Adam0Brien/USV-LIR-Microbit-Abstraction/README.md

# USV-LIR-Microbit-Abstraction
Final year project Applied Computing (IoT)

## Academic Title - "USV-Lir Micro: bit Sensor Pod Abstraction"

## Commercial Title - "Micro:Bit Sensor Pod breakout Board"
<br>
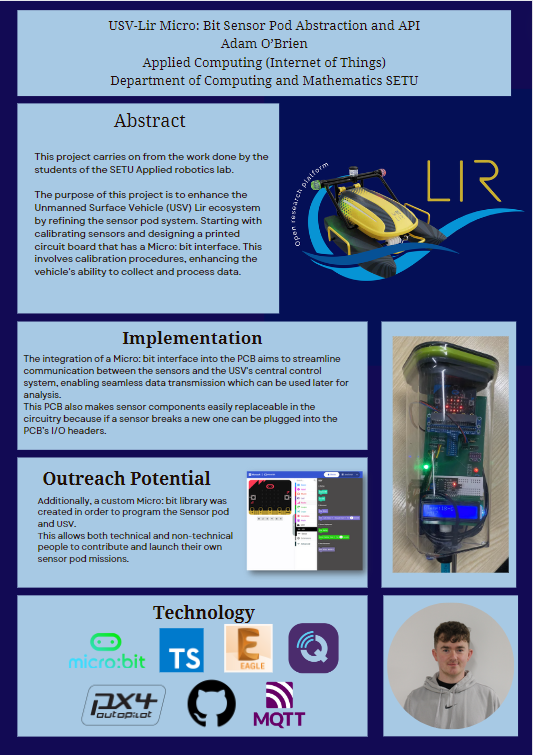
[picture p1: img/poster.png]

<br>
