Adam0Brien/USV-LIR-Microbit-Abstraction/docs/hardware.md

# Sensor Pod Hardware
This section will guide you through the hardware components of the project.

## Component Requirements

- Sensor Pod PCB 
- [Microbit Breadboard adapter](https://shop.sb-components.co.uk/products/bbc-micro-bit-breadboard-adapter)
- [I2C LCD Screen adapter](https://makershop.ie/I2C-Display-Backpack)
- [LCD Screen](https://makershop.ie/2004-lcd-display)
- [DS18B20 Arduino Temperature sensor](https://docs.rs-online.com/8ff0/A700000007238410.pdf)

- [DFRobot pH sensor](https://wiki.dfrobot.com/PH_meter_SKU__SEN0161_)
- [DFRobot Turbidity sensor](https://www.dfrobot.com/product-1394.html)
- LDR
- [Breadboard 3.3/5v power adapter](https://www.temu.com/ul/kuiper/un9.html?goods_id=601099524060004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)
- 4.7k Resistor (for temperature sensor)
- 10k Resistor (for LDR)
- 330 ohm Resistor x2 (Power LEDS)
- Pin sockets
- Enclosure

# Pin outs

On the sensor pod each sensor has its own dedicated pin slot, 
This means that components will only go one way into the device.

The I2C connections can be swapped aslong as the right voltage is being supplied to the I2C device. e.g. The LCD display must have 5v power to work correctly.

Below you will find the current PCB iteration along with letters over specific pins to indicate what those pins do.

- V = VCC (Power 3.3v or 5v)
- G = Ground
- S = Signal
- X = SDA (I2C)
- Y = SCL (I2C)

Sensor/I2C Micro: bit pin signals
- Temp -> Digital Pin 8
- pH -> Analog Pin 0
- Turbidity -> Analog Pin 1
- LDR -> Analog Pin 2
- M1 -> Analog Pin 3
- M2 -> Analog Pin 4
- SCL -> Pin 19
- SDA -> Pin 20

<div style="text-align: center;">
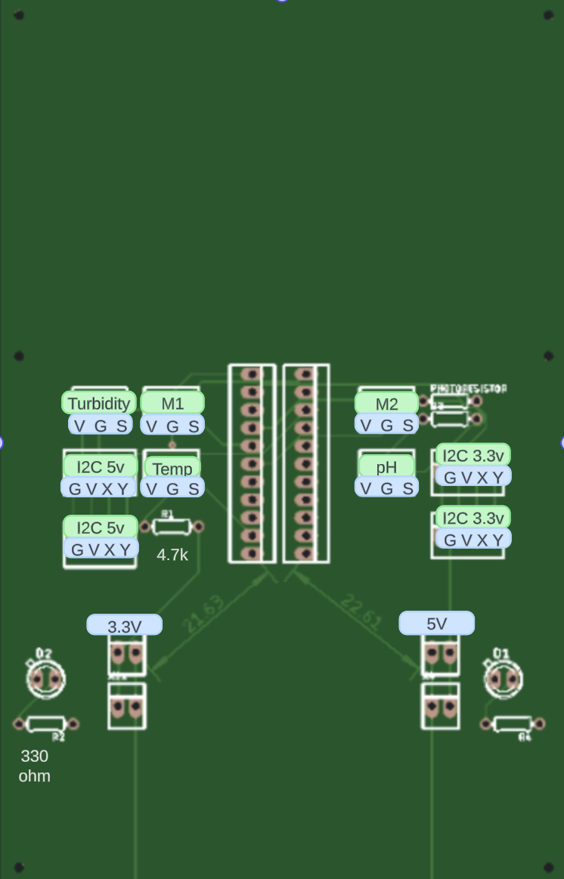
[picture p5: img/pcb-pinout.png]
        
</div>
