Adam0Brien/USV-LIR-Microbit-Abstraction/pcb-design/pdb.md

# USV-LIR-Microbit-Abstraction PCB Design

The following design contains connections for the microbit breadboard expantion board, power mb v2 board, 3x I2C pinouts, 2x Motor control pinouts and 3x sensor pinouts.

This makes the board usable for the sensor deployment system along with the microbit remote drive system.

<br>

<br>

<br>

<br>
