Adam0Brien/USV-LIR-Microbit-Abstraction/docs/pcb.md

# USV-LIR-Microbit-Abstraction PCB Design

The following design contains connections for the microbit breadboard expantion board, power mb v2 board, 3x I2C pinouts, 2x Motor control pinouts and 3x sensor pinouts.

This makes the board usable for the sensor deployment system along with the microbit remote drive system.

<br>
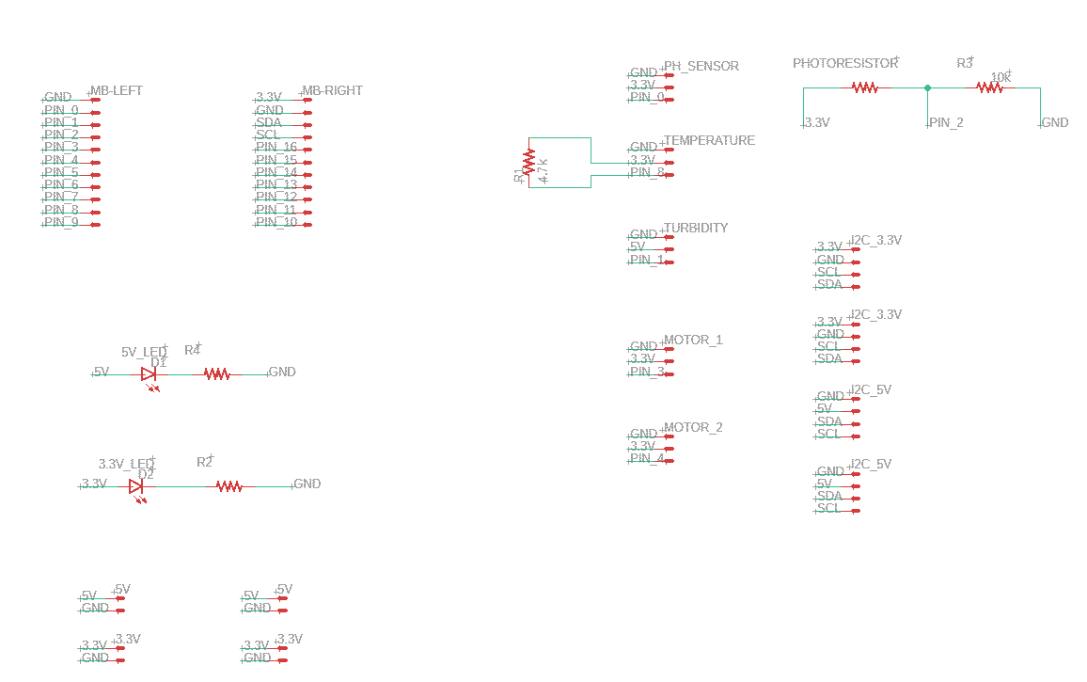
[picture p6: img/pcb-schematic.png]

<br>

<br>
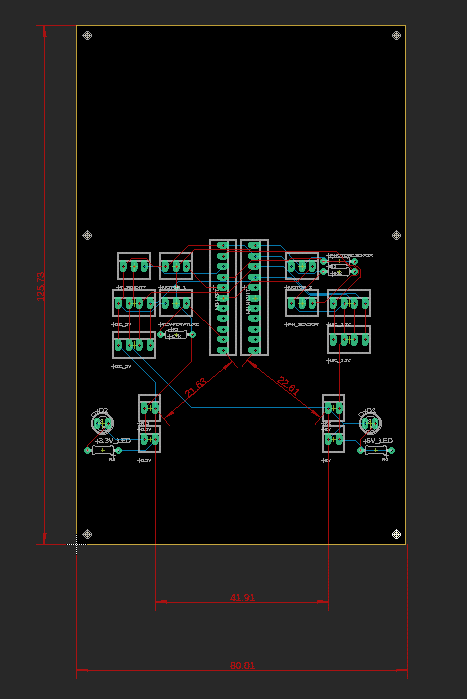
[picture p7: img/pcb.png]

<br>

<br>
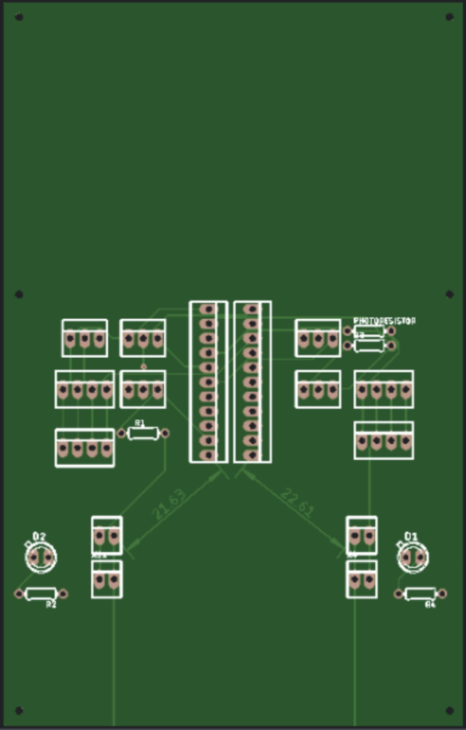
[picture p8: img/pcb-render.png]

<br>
