Adam0Brien/USV-LIR-Microbit-Abstraction/img/3DPrint.png

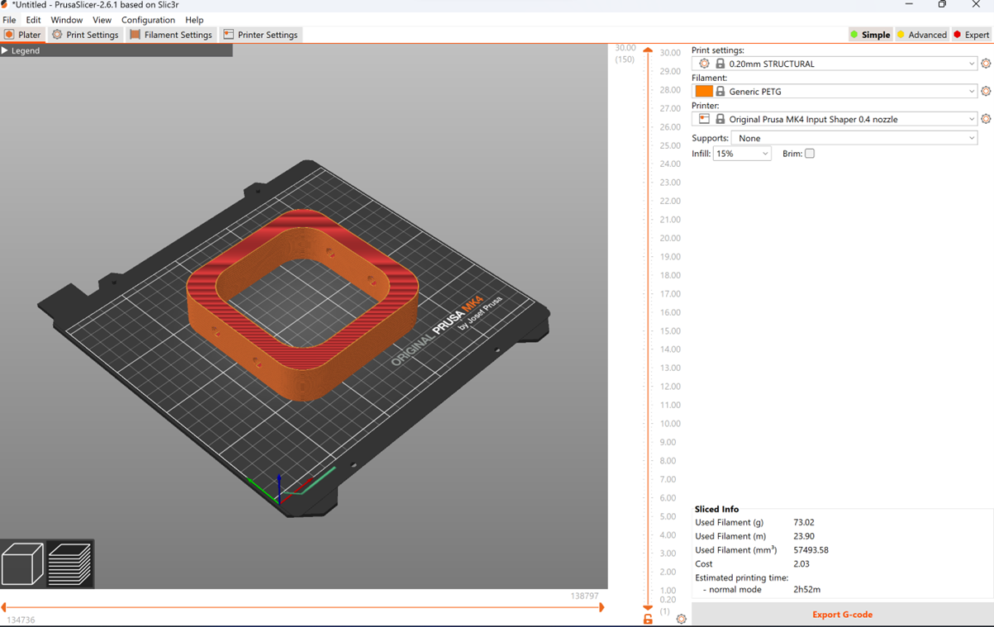
img/3DPrint.png
