Adam0Brien/USV-LIR-Microbit-Abstraction/img/USVLIR.jpg

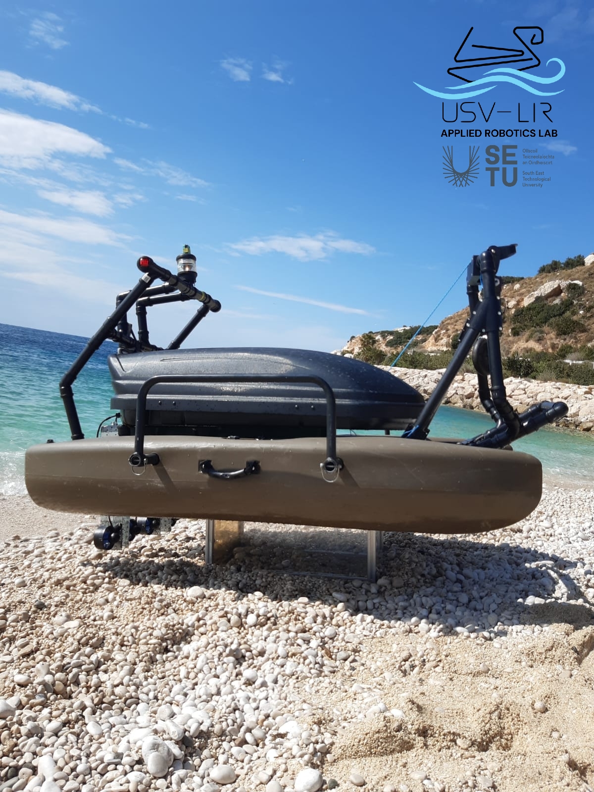
img/USVLIR.jpg
