Adam0Brien/USV-LIR-Microbit-Abstraction/3D Print Files/STL/Sensor-Pod-Inside.stl

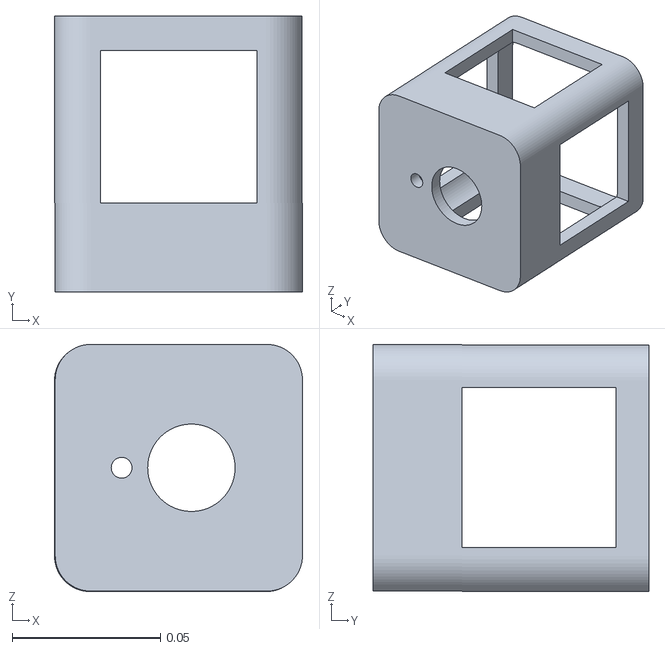
[picture p11: CAD file, 2024-04-24]
3D Print Files/STL/Sensor-Pod-Inside.stl
0.0836 x 0.0929 x 0.0833
