Adam0Brien/USV-LIR-Microbit-Abstraction/3D Print Files/STL/Sensor-Pod-Clamp.stl

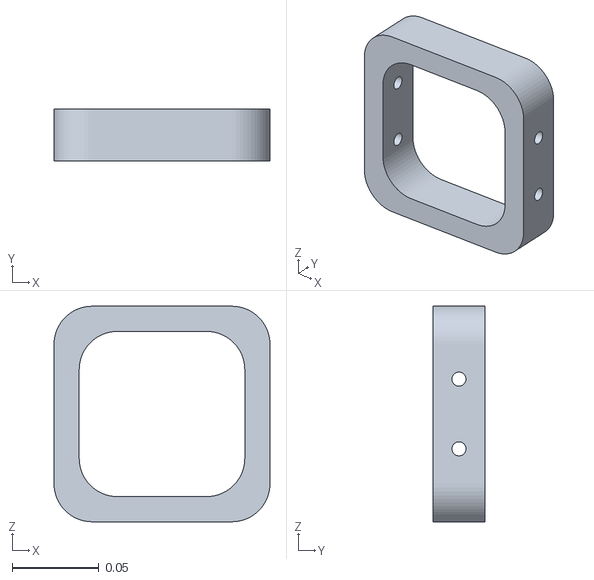
[picture p12: CAD file, 2024-04-24]
3D Print Files/STL/Sensor-Pod-Clamp.stl
0.125 x 0.03 x 0.124
