Adam0Brien/USV-LIR-Microbit-Abstraction/pcb-design/sensor-pod.brd

## EAGLE design pcb-design/sensor-pod.brd (2024-02-19)

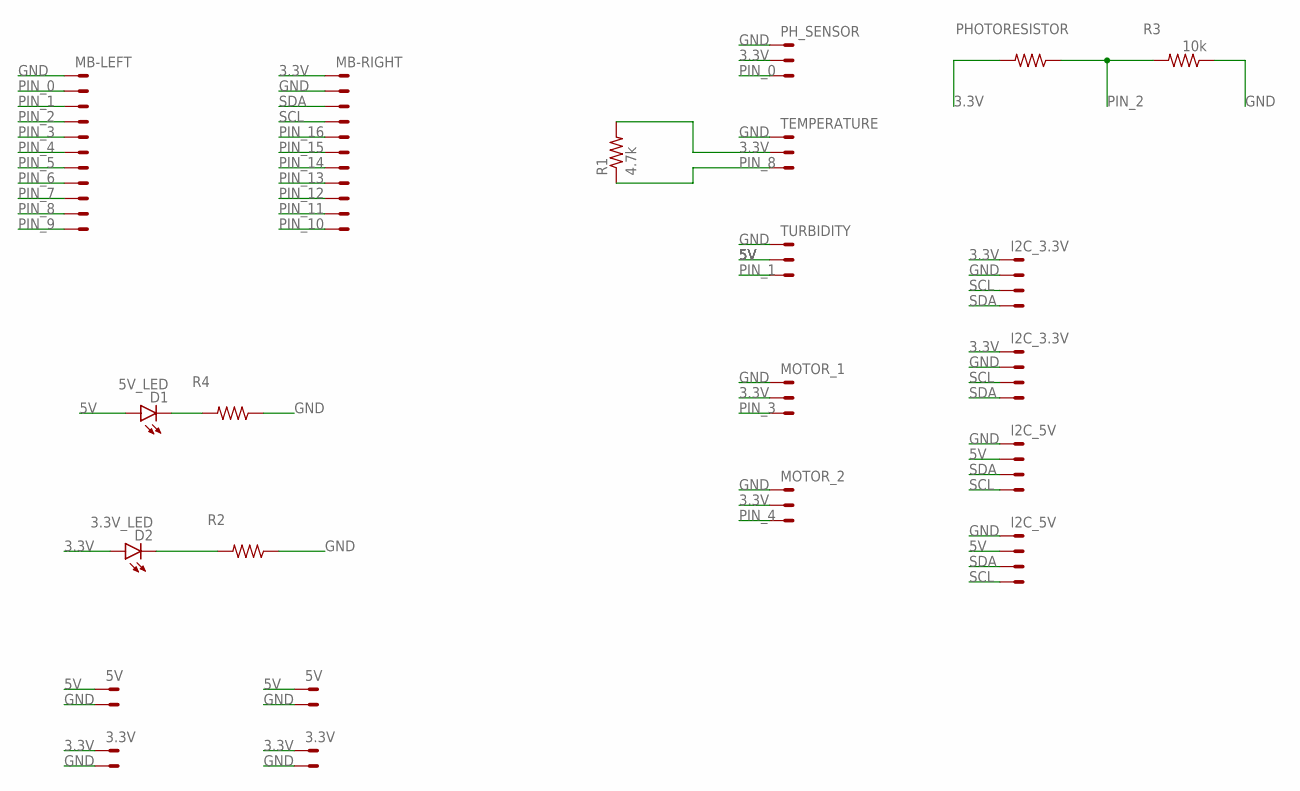
[picture p13: schematic sensor-pod.sch]

Parts:
1: 5V; 22-23-2021
D1: 5V_LED; SFH482
D2: 3.3V_LED; SFH482
PHOTORESISTOR: R-US_0204/7; 0204/7
R1: 4.7k; 0204/7
R2, R4: R-US_0204/7; 0204/7
R3: 10k; 0204/7
X1: PH_SENSOR; 22-23-2031
X2, X10: I2C_5V; 22-23-2041
X3: TURBIDITY; 22-23-2031
X4: 5V; 22-23-2021
X5: TEMPERATURE; 22-23-2031
X6: MOTOR_1; 22-23-2031
X7: MOTOR_2; 22-23-2031
X8, X9: I2C_3.3V; 22-23-2041
X11, X12: 3.3V; 22-23-2021
X15: MB-LEFT; 22-23-2111
X16: MB-RIGHT; 22-23-2111

Connections:
3.3V: D2.A, PHOTORESISTOR.2, R1.2, X1.2, X5.2, X6.2, X7.2, X8.1, X9.1, X11.1, X12.1, X16.1
5V: 1.1, D1.A, X2.2, X3.2, X4.1, X10.2
GND: 1.2, R2.1, R3.1, R4.1, X1.1, X2.1, X3.1, X4.2, X5.1, X6.1, X7.1, X8.2, X9.2, X10.1, X11.2, X12.2, X15.1, X16.2
unnamed: D1.K (C), R4.2
unnamed: D2.K (C), R2.2
PIN_0: X1.3, X15.2
PIN_1: X3.3, X15.3
PIN_2: PHOTORESISTOR.1, R3.2, X15.4
PIN_3: X6.3, X15.5
PIN_4: X7.3, X15.6
PIN_5: X15.7
PIN_6: X15.8
PIN_7: X15.9
PIN_8: R1.1, X5.3, X15.10
PIN_9: X15.11
PIN_10: X16.11
PIN_11: X16.10
PIN_12: X16.9
PIN_13: X16.8
PIN_14: X16.7
PIN_15: X16.6
PIN_16: X16.5
SCL: X2.4, X8.3, X9.3, X10.4, X16.4
SDA: X2.3, X8.4, X9.4, X10.3, X16.3

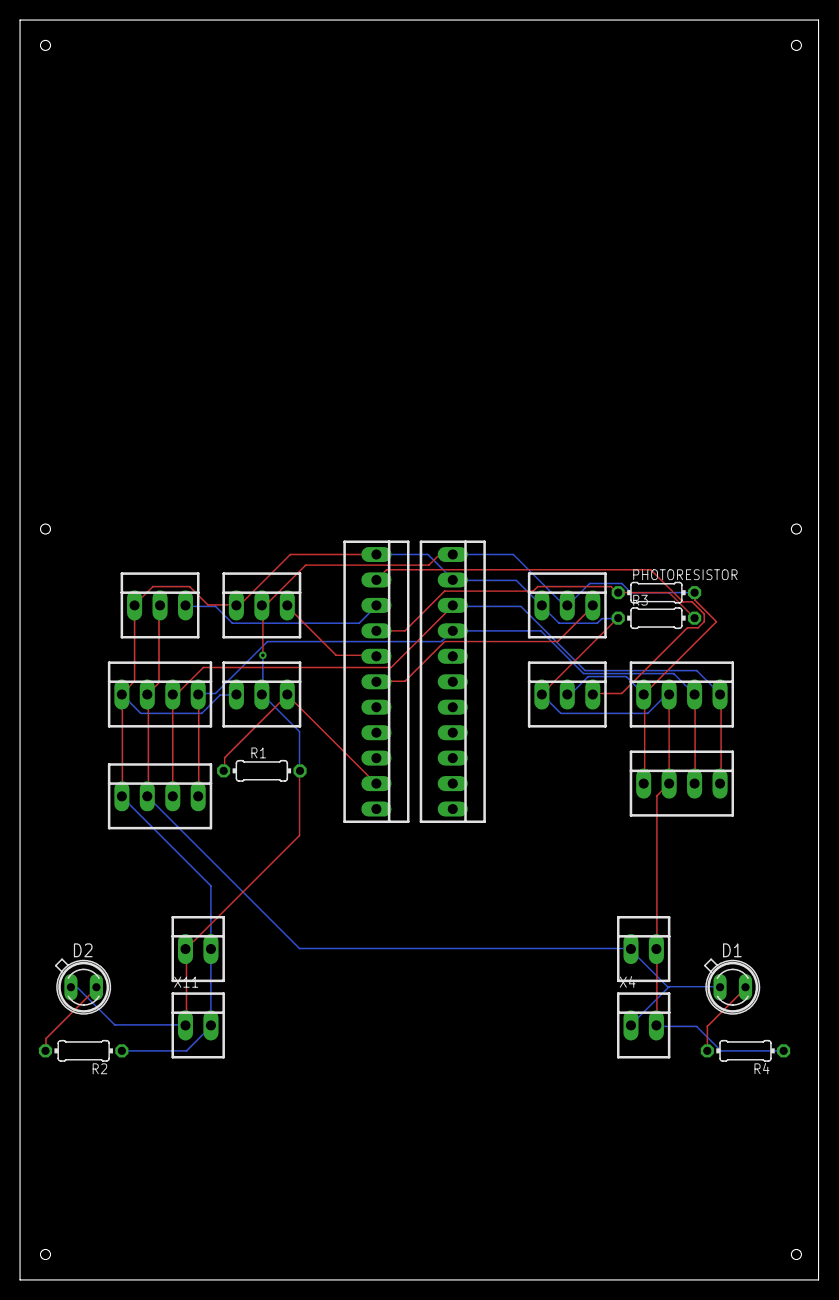
[picture p14: board sensor-pod.brd from above]

Board: 2 copper layers, 79.7 x 125.7 mm, 22 parts (0 on the bottom side), 13 nets.
