Adam0Brien/USV-LIR-Microbit-Abstraction/docs/getting-started.md

# Getting Started with USV-Lir Sensor Pod
Welcome to USV-Lir Sensor Pod! This document will guide you through the process of setting up and getting started with the project.

Prerequisites

Before you begin, make sure you are familiar with the following:

- BBC Microbit (or Scratch)
- Electronics (Not neccessary but an advantage)

## Usage
To get started with the USV-Lir Sensor Pod, follow these steps:

- Make sure that all sensors are attatched to the main PCB board.

- Install the Sensor Pod library to makecode
    - Open a new makecode project 
    - Switch to Javascript and open the dropdown menu labeled 'Explorer'
    
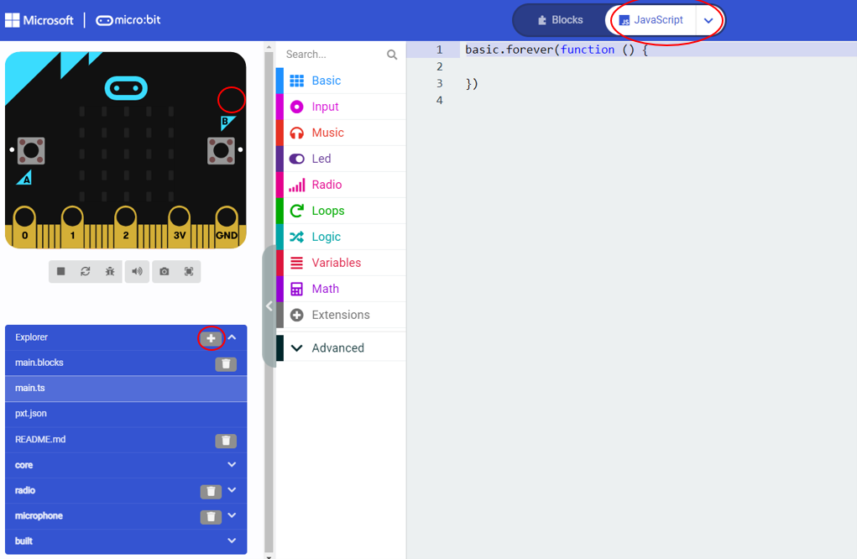
[picture p15: img/getting-started1.png]
    
    
    - Click on the '+' icon and make a new file called 'sensorPod.ts'
        
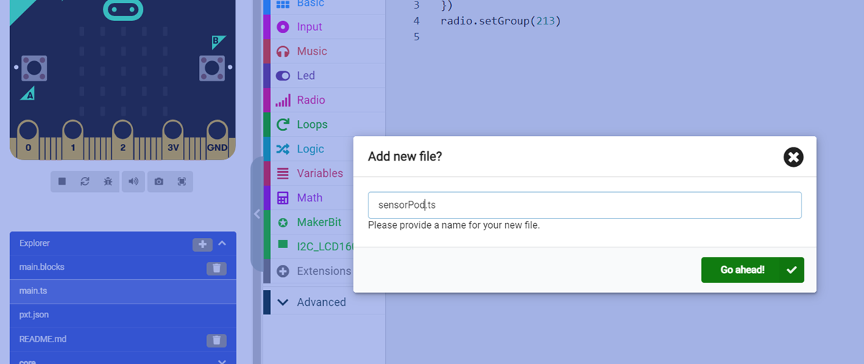
[picture p16: img/getting-started2.png]
    
    
    - Paste the code from https://github.com/Adam0Brien/USV-LIR-Microbit-Abstraction/blob/main/USV/sensor-pod/sensorPod.ts
    
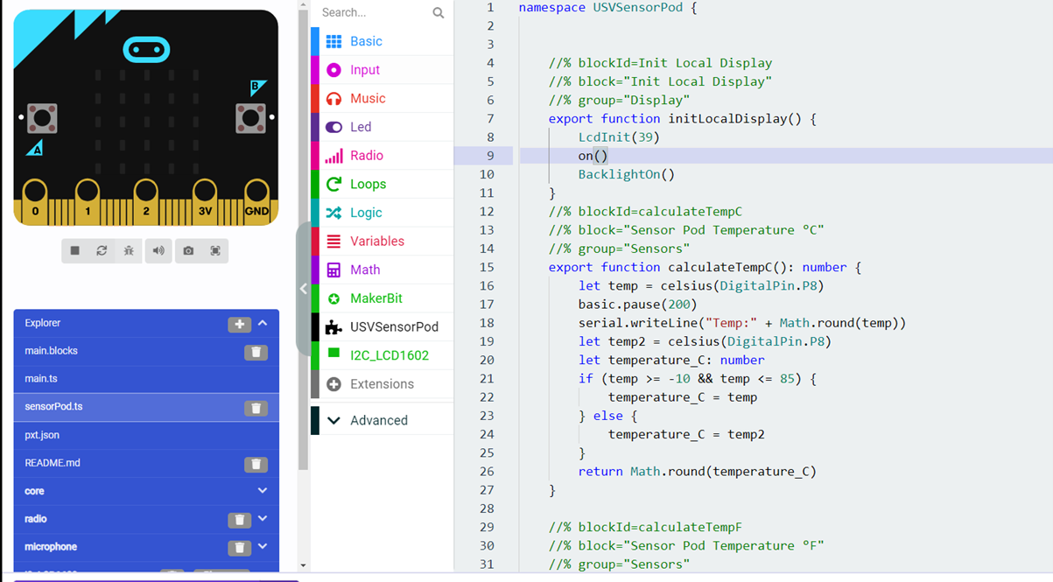
[picture p17: img/getting-started3.png]
    
    
    - Switch back from Javascript to Blocks
    
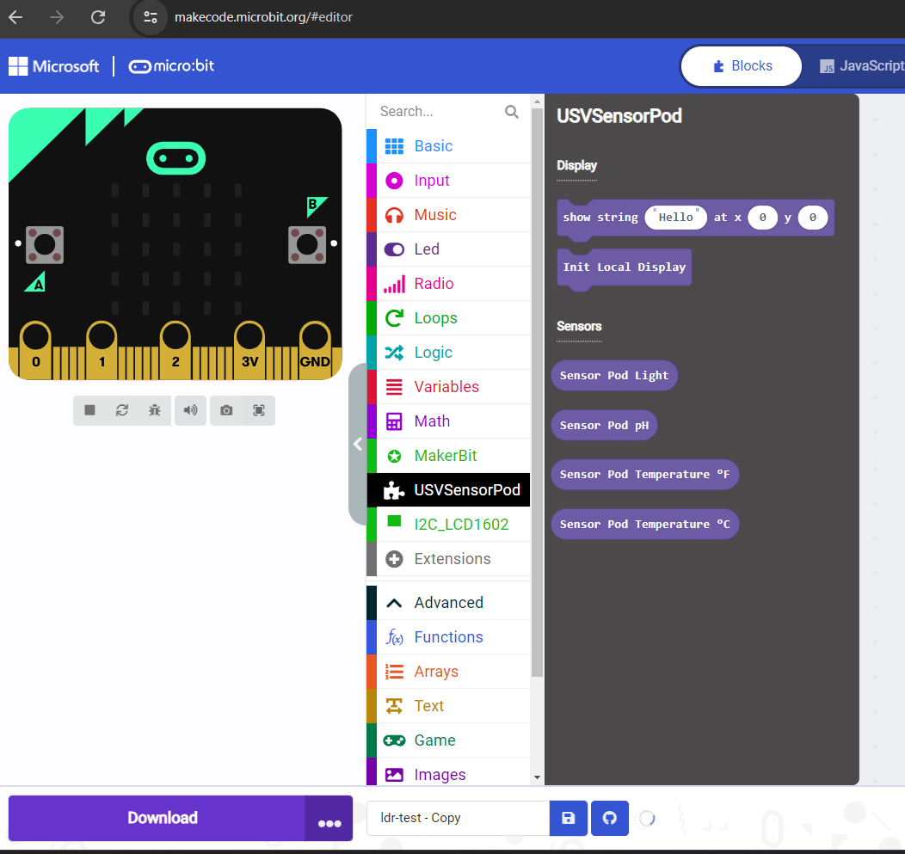
[picture p18: img/getting-started4.png]
    
    
    - Code your first sensor pod mission!!!
    
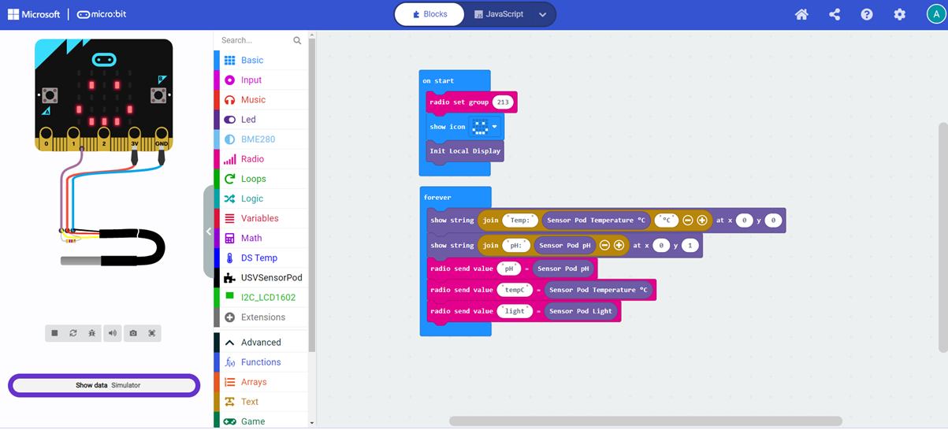
[picture p19: img/getting-started5.png]
    

## Contributing
If you're interested in contributing to USV-Lir Sensor Pod, please follow these guidelines:
 
#### Fork the repository.
- Clone respository
- Create a new branch: git checkout -b feature/your-feature.
- Make your changes and commit them: git commit -m 'feat: Add some feature'.
- Push to the branch: git push origin feature/your-feature.
- Submit a pull request.

# Contact
If you have any questions or need further assistance, feel free to contact me at adamobrieniot@gmail.com.
