Adam0Brien/USV-LIR-Microbit-Abstraction/(threads)

Thread 15 (2024-03-11):

Implement USV Sensor Deployment mechanism into Microbit library

Adam0Brien, 2024-03-11:
Using the breakout pins on the microbit expantion board make a microbit makeblock that lets a user gain access to the USV's sensor deployment mechanism.

This paired with #14 will allow users to drive the USV to a location and deploy the sensor pod.

e.g.

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

Note:
Currently the Sensor deployment mechanism is wired directly into the Pixhawk meaning that there is no current microbit implementation of this feature

This is a major change compared to #14 because for this change the wiring will have to be altered so it is directly connected to the MUX.

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

Adam0Brien, 2024-03-14:
After todays lab testing the following has been completed:
- Crane up/down connection has been rewired from the Pixhawk to the MUX
- MUX output is only connected to the microbit for now.
- Added a Stop option to the Crane dropdown
- Wrote makecode for making the crane move up/down on a button press
- Added safety code on the controller so when the A or B button is released the Crane will stop moving

Reciever Code:
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

Controller Code:
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

Adam0Brien, 2024-03-15:
Lab Work competed today,

- Wired Pixhawk into MUX
- Tested microbit and Pixhawk sensor deployment modes and both work
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

Adam0Brien, 2024-03-15:
Finished Product

- Features a seconds variable that will send the sensor pod up/down for x amount of seconds
- Separate Stop makeblock

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

Closed 2024-03-15.

Thread 16 (2024-03-11):

Create USV to Sensor pod comms

Adam0Brien, 2024-03-11:
Currently the Sensor pod library is used to code the sensor pod itself.

The proposed change will take place in the USV library.

The sensor drop down will be used for the USV to communicate with the sensor pod Via radio comms.
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
The only values that will be available are the sensors themselves.
e.g.
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

The end goal of this PR is to be able to have the sensor pod pre-loaded with its own script that takes measurements when it is submerged and to have the USV ask for sensor pod metrics once it re-emerges from the water

Adam0Brien, 2024-04-04:
Opted to make a generic block that the user can select what value they want to look at

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

Thread 17 (2024-03-14):

Create Mounting Bracket for Sensor pod

Adam0Brien, 2024-03-14:
Currently the sensor pod has no means of attaching to the Crane mechanism...

Design and manufacture a simple means of attaching the sensor pod the crane mechanism.

Adam0Brien, 2024-03-14:
3D design for half of a bracket.

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

Printing two brackets will allow the brackets to act as a clamp by connecting them with threaded bar to keep the sensor pod attatched to the USV's Crane

Adam0Brien, 2024-03-15:
On second thought two separate pieces would make it harder to disassemble the sensor pod, instead of this a full bracket will be printed.

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

Adam0Brien, 2024-03-16:
Finished Product:

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

Closed 2024-03-15.

Thread 20 (2024-03-15):

Implement USV Sensor Pod to Beebotte Cloud

Adam0Brien, 2024-03-15:
Previously the USV had been able to be controlled and viewed from the IoT MQTT Panel Application.

Using the DFRobot Microbit IoT Cloud board the following has to be completed.

  - Sensor deployment control via App
  - Motor control via App (Needs #14)
  - Sensor Pod data being sent to Beebotte/IoT App (Needs #16)

This feature will enable the Sensor Pod to send data back to the cloud board for viewing sensor pod metrics

Closed 2024-04-06.

Thread 22 (2024-03-19):

Implement Motor control via micro:bit Compass position.

Adam0Brien, 2024-03-19:
**This feature would bring the addition of two new make blocks for the library.**
Using the motor control functions merged in #14

- Get USV direction (return a compass value)
- Drive USV North at X%  (sends radio messages based on compass value)
     - An example would be: if the USV is facing south turn until it is facing north, then once it is north drive the USV motors for X time
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

**Additional context**
This should work by having one micro:bit being used as a dedicated compass for the system that sends its position to the motor control micro:bit.
Once the compass has been positioned at north it should start to move the USV's motors at the desired speed selected for X amount of time

Adam0Brien, 2024-03-22:
Concept of what the new makeblock could look like:

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

Adam0Brien, 2024-03-22:
Progress made during todays lab time:

- Created a microbit script that moves USV motors using Microbit A. Controlled by the direction Microbit B's compass is pointing
- This script will power the USV's Thrusters and adjust for any deviation the USV might see on the water and keep it moving in the direction selected
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

Adam0Brien, 2024-03-26:
### Work done in lab today:

- Fixed Correct Course Logic
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

- Made demo video of code working with USV Thrusters.

## TODO

Give the drive north command a timer variable.
Make sure it is within the correct degree direction before timer starts to count down

Current version:
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

Intended version:
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

Closed 2024-04-04.
