Adam0Brien/USV-LIR-Microbit-Abstraction/(commit log)

2024-01-17 pcb-design: Added initial PCB design for sensor pod
    [sensor-pod.brd, sensor-pod.sch]
2024-01-17 pcb-design: Added pcb.md along with screenshots of design
2024-01-18 pcb-design/pcb.md: Correct image file extention
2024-01-18 pcb-design: Changed board layout and assigned pins for sensors.
    [sensor-pod.brd, sensor-pod.sch]
2024-01-23 Added Temperature sensor code.
2024-02-01 Sensor pod: Fix temp sensor code to use P8 + Changed PCB to match
    [sensor-pod.brd, sensor-pod.sch]
2024-02-01 Updated pcb schematic
2024-02-01 Sensor pod: Added pH sensor script
2024-02-06 pcb-design: Draft 2 Added LDR and power LED's + Changed board size/placement
    [sensor-pod.brd, sensor-pod.sch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]
2024-02-08 sensor-scripts: Added LDR code that interfaces with LCD
2024-02-11 pcd-design: Decreased distance between components and microbit interface. Increased PCB size.
    [sensor-pod.brd, sensor-pod.sch]
2024-02-19 Sensor-pod local temp test.
    [sensor-pod.brd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]
2024-02-29 feat: Added temperature sensor dependancies from microbit-dstemp
2024-03-01 docs: Added getting started docs page, renamed main.ts to sensorPod.ts
2024-03-01 Delete microbit-usv-lib directory
    Removed old Micro: bit Sensor pod library,
    Newest version is located in sensor-pod/sensorPod.ts
2024-03-07 Moved: pcb-design/pcb.md -> docs/pcb.md
2024-03-07 docs/hardware.md: Update Microbit pin connections
2024-03-15 3D-Prints: Added sensor pod bracket
2024-03-15 feat: Added sensor deployment mechanism to USV-API.
2024-03-20 USV/feat: Added Makecode blocks for Motor Control
2024-04-02 Fix: Sensor deploy triggering unexpectedly
2024-04-02 feat: Added Sensor Pod to USV Comms.
2024-04-02 Feat: Add sensor pod Auto Drive
2024-04-03 fix: USV/USV.ts adjust left motor code to account for CCW motor
2024-04-04 feat: Added Listen for sensor pod data block
2024-04-24 USV: Changed USV Sensor deploy and USV-Mode to Radio Recieved String/Number
2024-04-24 USV: Remove local Arm for radio Arm
